RolandSobczak/stm32wba-dev/parts/Foshan_NationStar_Optoelectronics_NCD1206C1/LED1206_INF.step

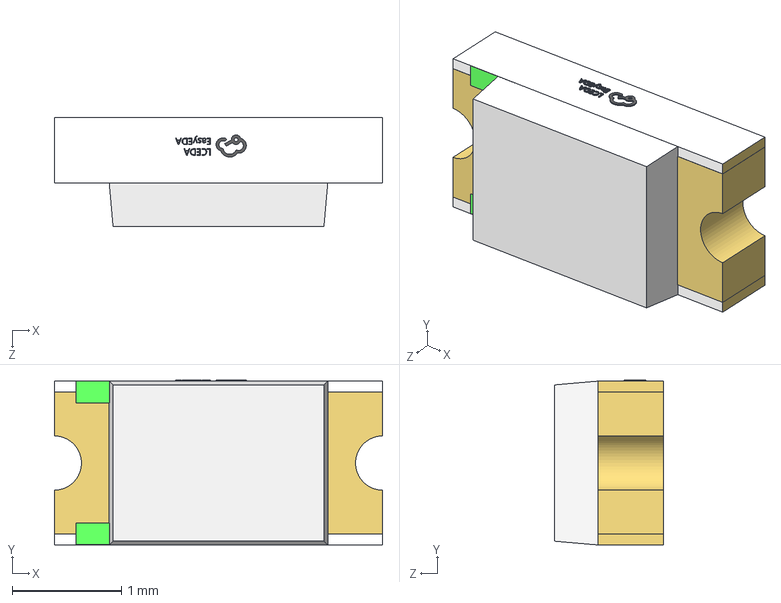
[picture p1: CAD file, 2026-10-15]
parts/Foshan_NationStar_Optoelectronics_NCD1206C1/LED1206_INF.step
3.00 x 1.51 x 1.00 mm
