RolandSobczak/stm32wba-dev/parts/Global_Connector_Technology_USB4085_GF_A/USC-C-SMD_USB4085-GF-A.step

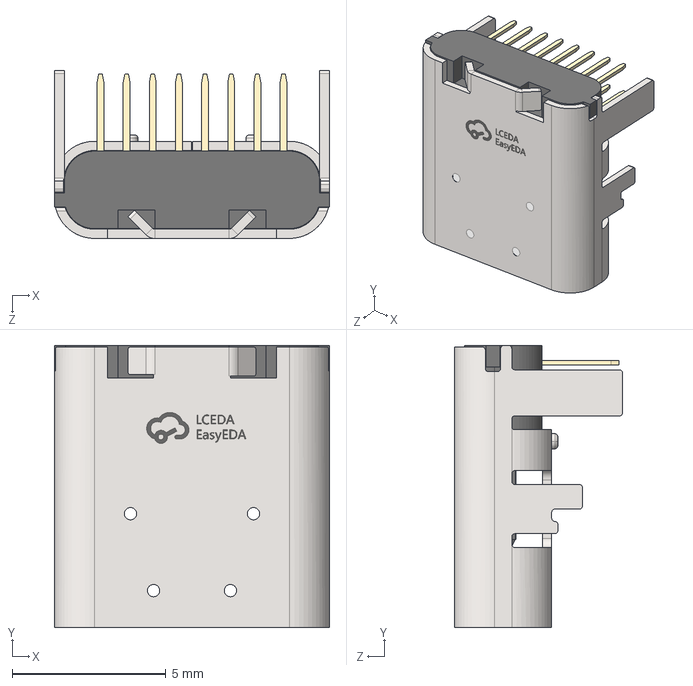
[picture p2: CAD file, 2026-10-14]
parts/Global_Connector_Technology_USB4085_GF_A/USC-C-SMD_USB4085-GF-A.step
8.94 x 9.17 x 5.46 mm
