RolandSobczak/stm32wba-dev/parts/MK_MKDV2GCL_ABF/LGA-8_L8.0-W6.0-P1.27_MKDV2GCL-ABF.step

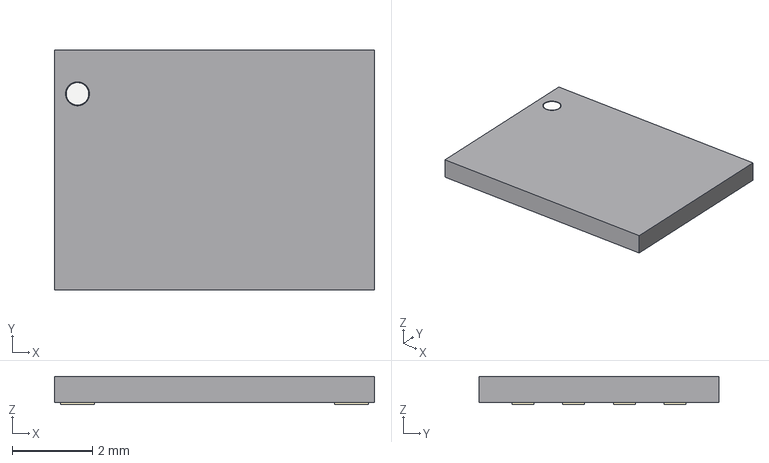
[picture p3: CAD file, 2026-10-15]
parts/MK_MKDV2GCL_ABF/LGA-8_L8.0-W6.0-P1.27_MKDV2GCL-ABF.step
8.00 x 6.00 x 0.7 mm
