RolandSobczak/stm32wba-dev/parts/Samtec_SHF_105_01_L_D_RA/SHF-105-01-L-D-RA.STEP

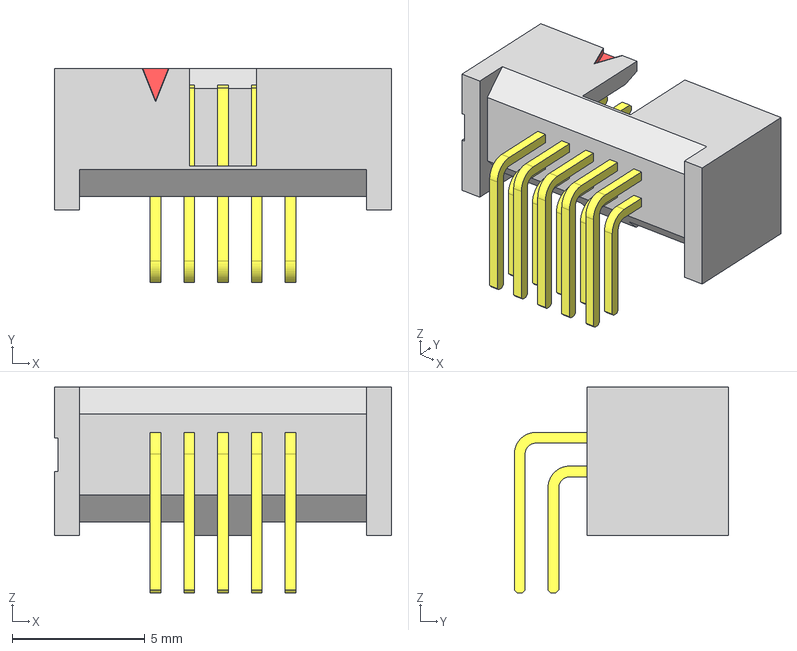
[picture p4: CAD file, 2026-10-14]
parts/Samtec_SHF_105_01_L_D_RA/SHF-105-01-L-D-RA.STEP
12.7 x 8.08 x 7.75 mm
SHF-105-01-D_header
SHF-First_Position_Indicator
T-1S71-02-05-D-RA
