RolandSobczak/stm32wba-dev/parts/STMicroelectronics_MLPF_WB55_01E3/FILTER-SMD_6P-L1.6-W1.0-P0.50-BL.step

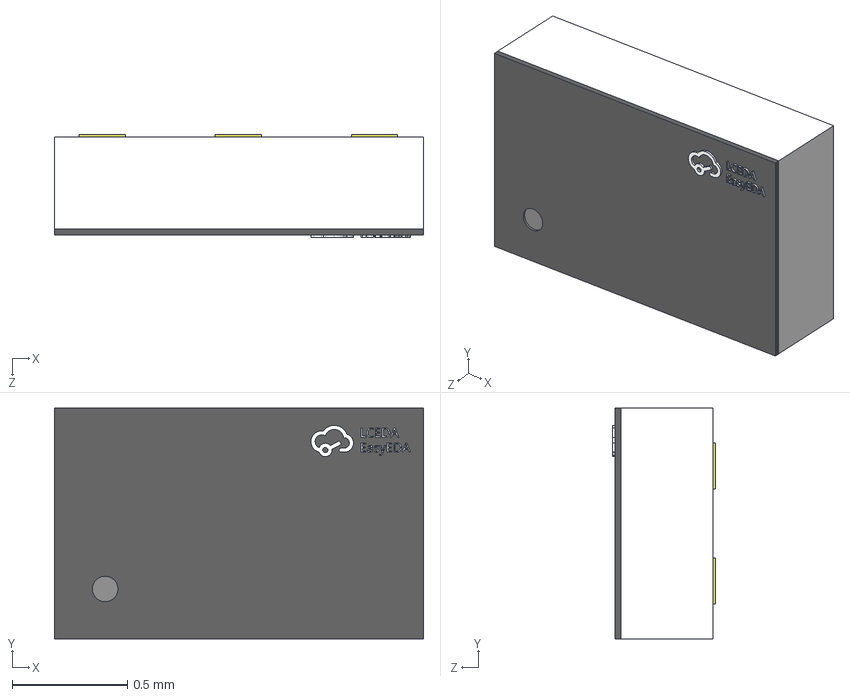
[picture p5: CAD file, 2026-10-14]
parts/STMicroelectronics_MLPF_WB55_01E3/FILTER-SMD_6P-L1.6-W1.0-P0.50-BL.step
1.60 x 1.00 x 0.445 mm
