RolandSobczak/stm32wba-dev/parts/STMicroelectronics_STM32WB55CGU6/VQFN-48_L7.0-W7.0-P0.50-BL-EP5.5.step

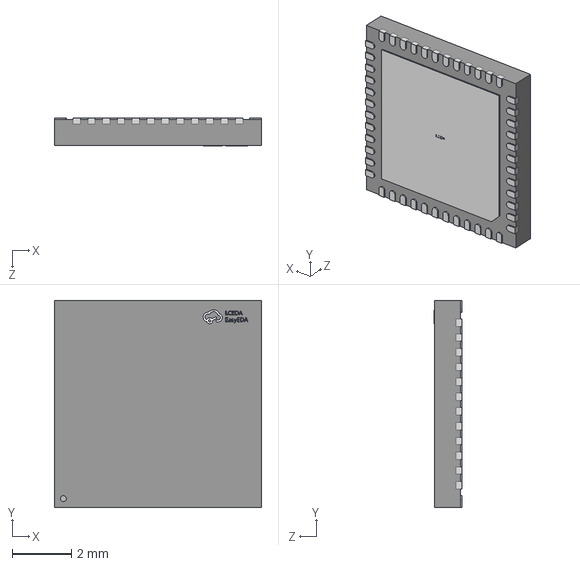
[picture p6: CAD file, 2026-10-14]
parts/STMicroelectronics_STM32WB55CGU6/VQFN-48_L7.0-W7.0-P0.50-BL-EP5.5.step
7.00 x 7.00 x 0.931 mm
