RolandSobczak/stm32wba-dev/parts/MK_MKDV2GCL_ABF/LGA-8_L8.0-W6.0-P1.27-TL_MKDV4GCL-ABF.STEP

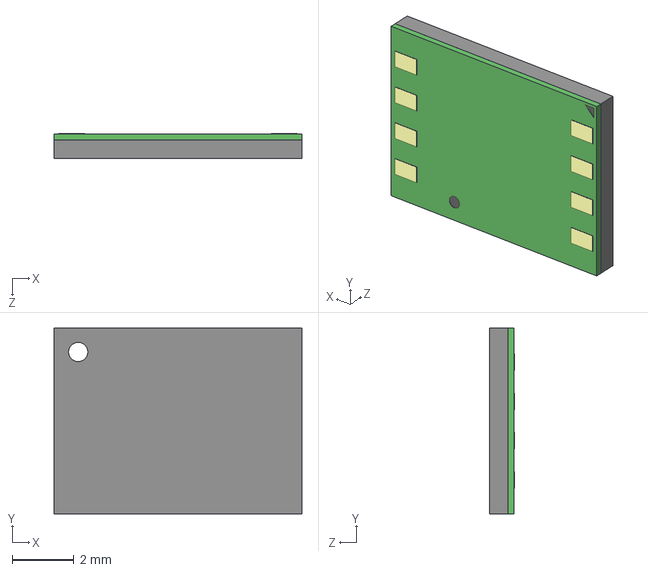
[picture p7: CAD file, 2026-10-14]
parts/MK_MKDV2GCL_ABF/LGA-8_L8.0-W6.0-P1.27-TL_MKDV4GCL-ABF.STEP
8.00 x 6.00 x 0.81 mm
