RolandSobczak/stm32wba-dev/layouts/dev/dev.kicad_pcb

## KiCad design layouts/dev/dev.kicad_pcb (2026-10-17)

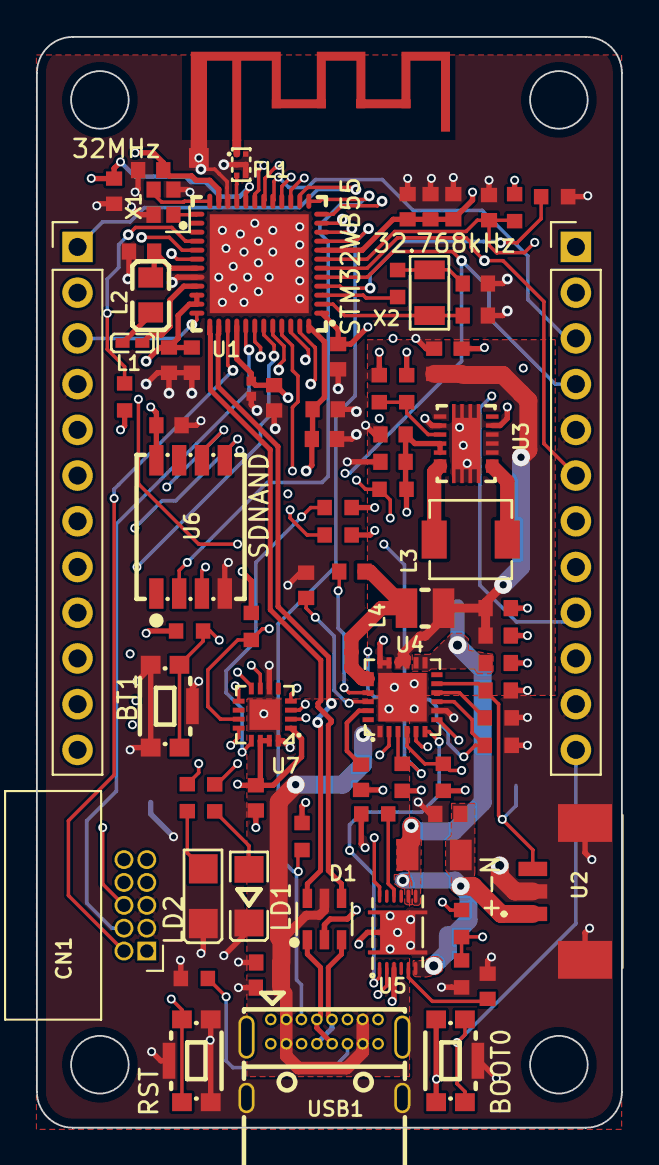
[picture p8: board dev.kicad_pcb from above]

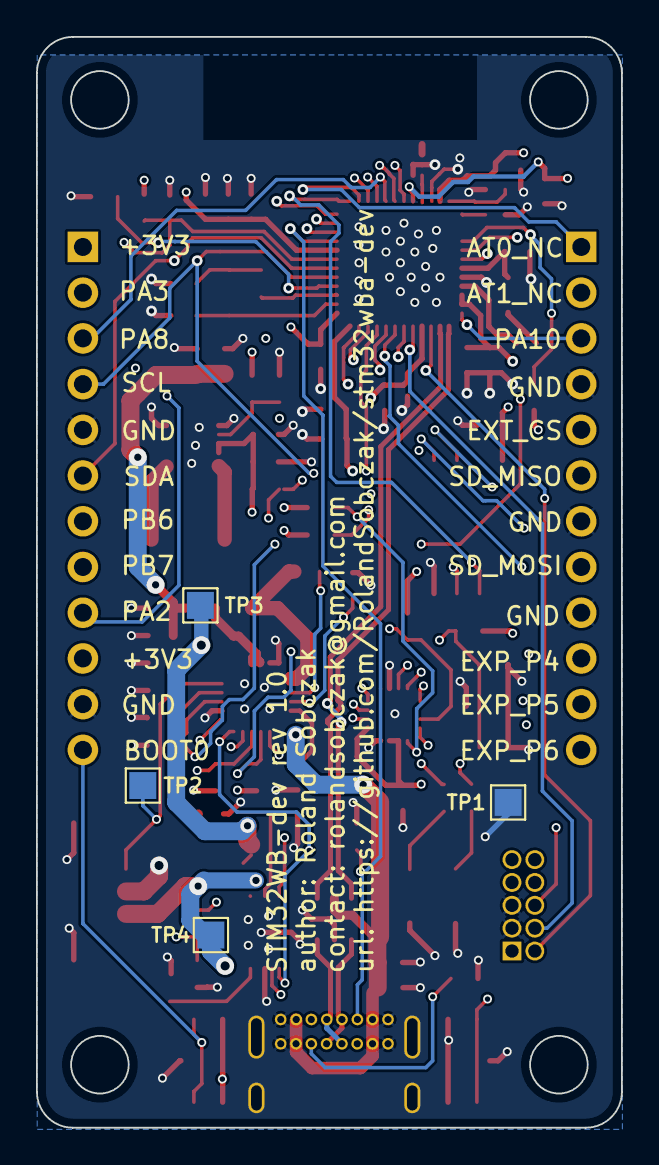
[picture p9: board dev.kicad_pcb from below]

Board: 6 copper layers, 32.5 x 60.6 mm, 85 parts (4 on the bottom side), 66 nets.

Parts:
AE1: Antenna_IFA_2G4
C1, C8, C9, C23: 4.7µF ±10%; C0603
C2, C3, C4, C7, C10, C12, C13, C15, C19, C26, C32, C33: 100nF ±10%; C0603
C5, C6: 12pF ±5%; C0603
C11, C27, C28, C29: 1µF ±10%; C0603
C14: 100pF ±5%; C0402
C16, C20, C22, C30, C31: 10µF ±20%; C0603
C17, C18, C24, C25: 22µF ±20%; C0603
C21: 47nF ±10%; C0603
CN1: CONN-THT_10P-P1.27_SHF-105-01-L-D-RA
D1: SOT-23-6_L2.9-W1.6-P0.95-LS2.8-BL
FL1: FILTER-SMD_6P-L1.6-W1.0-P0.50-BL
J1, J2: PinHeader_1x12
L1: L 10nH ±5%; L0402-RD
L2: L 10µH ±20%; L0805
L3: L 1.5µH ±20%; IND-SMD_L4.4-W4.2
L4: L 1µH ±20%; IND-SMD_L2.5-W2.0
LED1: LED1206-RD
LED3: LED1206-R-RD_RED
R1, R10, R14, R15, R16, R17, R20, R22: 10kΩ ±1%; R0603
R2: 0Ω; R0603
R3, R6: 100kΩ ±1%; R0603
R4: 180kΩ ±0.1%; R0603
R5: 1MΩ ±1%; R0603
R7: 121Ω ±0.1%; R0603
R8: 30kΩ ±0.5%; R0603
R9: 5.23kΩ ±1%; R0603
R11: 10mΩ ±1%; R1206
R12, R13: 4.7kΩ ±1%; R0603
R18, R19: 5.1kΩ ±1%; R0603
R23, R25: 1kΩ ±1%; R0603
SW1, SW2, SW3: KEY-SMD_KMR2XXGXXX
TP1, TP2, TP3, TP4: TestPoint_Pad_D1R5
U1: VQFN-48_L7.0-W7.0-P0.50-BL-EP5.5
U2: 532610371_Molex_PicoBlade_3Pin_1_25
U3: VSON-14_L4.0-W3.0-P0.50-BL-EP_TI_DSJ
U4: QFN-24_L4.0-W4.0-P0.50-TL-EP2.7
U5: SON-12_L4.0-W2.5-P0.40-TL-EP
U6: LGA-8_MKDV_handsolder
U7: QFN-16_L3.0-W3.0-P0.50-BL-EP1.7
USB1: USC-C-SMD_USB4085-GF-A
X1: CRYSTAL-SMD_4P-L2.0-W1.6-BL
X2: CRYSTAL-SMD_L3.2-W1.5-1

Connections:
+3V3: C1.1, C2.1, C3.1, C4.1, C8.1, C10.1, C11.1, C12.1, C13.1, C14.1, C15.1, C17.1, C18.1, C31.1, C32.1, C33.1, CN1.1, J1.1, J1.10, R3.1, R5.1, R12.1, R13.1, R14.1, R15.1, R16.1, R17.1, R20.1, R22.1, SW1.3, SW1.4, U1.1, U1.8, U1.20, U1.23, U1.34, U1.35, U1.40, U1.48, U3.4, U3.5, U6.8, U7.1, U7.14, U7.15
ANT: AE1.1, FL1.1
BIN: R10.1, U5.10
BOOT0: J1.12, R1.1, SW1.1, SW1.2, U1.4
BTN_USR: R20.2, SW3.1, SW3.2, U7.4
BTST: C21.1, U4.21
CC1: R18.1, U1.9, USB1.A5
CC2: R19.1, U1.10, USB1.B5
CHG_CE: R6.1, U1.29, U4.9
CHG_INT: R16.2, U1.28, U4.7
CHG_PG: R14.2, U1.30, U4.3
CHG_STAT: R15.2, U1.19, U4.4
EXP_INT: R22.2, U1.45, U7.11
EXP_LED0: R25.1, U7.2
EXP_LED1: R23.1, U7.3
EXP_P4: J2.10, U7.7
EXP_P5: J2.11, U7.8
EXP_P6: J2.12, U7.9
EXT_CS: J2.5, U1.42
FB: R4.1, R5.2, U3.3
GAUGE_INT: R17.2, U1.44, U5.12
GAUGE_VDD_1V8: C29.1, U5.5
GND: AE1.2, C1.2, C2.2, C3.2, C4.2, C5.2, C6.2, C7.2, C8.2, C9.2, C10.2, C11.2, C12.2, C13.2, C14.2, C15.2, C16.2, C17.2, C18.2, C19.2, C20.2, C22.2, C23.2, C24.2, C25.2, C26.2, C27.2, C28.2, C29.2, C30.2, C31.2, C32.2, C33.2, CN1.3, CN1.5, D1.2, FL1.2, FL1.4, FL1.5, FL1.6, J1.5, J1.11, J2.4, J2.7, J2.9, LED1.1, LED3.2, R1.2, R4.2, R6.2, R7.2, R8.2, R10.2, R18.2, R19.2, SW1.5, SW2.3, SW2.4, SW2.5, SW3.3, SW3.4, SW3.5, TP1.1, U1.22, U1.32, U1.49, U2.2, U2.4, U2.5, U3.2, U3.13, U3.15, U4.8, U4.17, U4.18, U4.25, U5.3, U5.13, U6.4, U7.6, U7.16, U7.17, USB1.A1, USB1.A12, USB1.B1, USB1.B12, USB1.S1, X1.2, X1.4
LED0_A: LED3.1, R25.2
LED1_A: LED1.2, R23.2
LIIM: R7.1, U4.10
LSE_IN: C5.1, U1.2, X2.1
LSE_OUT: R2.1, U1.3
LSE_XTAL: C6.1, R2.2, X2.2
NRST: C7.1, CN1.10, R3.2, SW2.1, SW2.2, U1.7
NTC: C26.1, R8.1, R9.2, TP2.1, U2.3, U4.11
OSC_IN: U1.25, X1.1
OSC_OUT: U1.24, X1.3
PA2: J1.9, U1.11
PA3: J1.2, U1.12
PA8: J1.3, U1.17
PA9: J2.2, U1.18
PA10: J2.3, U1.36
PB6: J1.7, U1.46
PB7: J1.8, U1.47
PMIC_SCL: J1.4, R12.2, U1.5, U4.5, U5.2, U7.12
PMIC_SDA: J1.6, R13.2, U1.6, U4.6, U5.1, U7.13
PMID: C22.1, U4.23
REGN: C23.1, R9.1, U4.2, U4.22
RF1: FL1.3, U1.21
SD_CLK: J2.1, U1.14, U6.3
SD_CS: U1.13, U6.2
SD_MISO: J2.6, U1.15, U6.6
SD_MOSI: J2.8, U1.16, U6.5
SMPS_MID: L1.2, L2.1
SWCLK: CN1.4, U1.41
SWDIO: CN1.2, U1.39
SWO: CN1.6, U1.43
SW_BAT: L3.1, U3.8, U3.9
SW_CHG: C21.2, L4.1, U4.19, U4.20
SW_OUT: L3.2, U3.6, U3.7
SYS: C16.1, C19.1, C24.1, C25.1, L4.2, U3.1, U3.10, U3.11, U3.12, U4.15, U4.16
USB_CONN_N: D1.3, USB1.A7, USB1.B7
USB_CONN_P: D1.1, USB1.A6, USB1.B6
USB_D_N: D1.4, U1.37
USB_D_P: D1.6, U1.38
VBAT: C28.1, R11.1, TP4.1, U2.1, U5.6, U5.8
VBAT_CHG: C20.1, R11.2, TP3.1, U4.13, U4.14, U5.7
VBUS: C27.1, C30.1, D1.5, U4.1, USB1.A4, USB1.A9, USB1.B4, USB1.B9
VFBSMPS: C9.1, L2.2, U1.31
VLXSMPS: L1.1, U1.33
