RolandSobczak/stm32wba-dev/(commit log)

2026-10-14 feat: STM32WB55 dev board - source, netlist, stackup and outline
    Power path lifted from gps_tracker-6l almost verbatim, comments included:
    GCT USB-C + USBLC6, BQ25896 NVDC charger, BQ27441 gauge with the shunt on
    the high side, TPS63020 buck-boost and the same Molex PicoBlade, so one
    cell fits both boards.
    Three things had to change and each is argued in the file:
    * CC without PD - STM32WB55 has no UCPD (checked against the peripheral
    list in STM32WB55CGUx.xml), so two 5.1k Rd plus an ADC on both CC
    nodes. The source advertises its current through Rp regardless of PD;
    firmware reads it, writes IINLIM and kicks FORCE_ICO. Side effect is
    welcome: Rd works with a dead MCU, so a freshl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
2026-10-14 feat: SWD on a proper ARM Cortex Debug connector
    Samtec SHF-105-01-L-D-RA, right-angle, keyed shroud, 2x5 at 1.27 mm. The
    J-Link EDU Mini cable plugs straight in, and so does ST-LINK V2/V3 - it is
    a standard rather than somebody's pin order. Right-angle because a vertical
    one with the cable attached stands about 7 mm above the laminate, exactly
    where a probe and fingers need to be during bring-up.
    Two grounds sit between the fast lines (pin 3 between SWDIO and SWCLK,
    pin 5 between SWCLK and SWO), so each has a return in the neighbouring
    ribbon wire. That matters most for SWO, which carries the ITM console.
    The four positions on the left header that used to carry SWD (5 NRST,
    6 SWDIO, 8 SWC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
2026-10-14 docs: list the SWD connector among the parts bought outside LCSC
    Claude-Session: https://claude.ai/code/session_01BM8NndJbzBEDPtrpVjN835
2026-10-14 chore: board file after the SWD rebuild
    ato build plus board_setup.py, no source change. Picks up CN1 in the PCB
    and the net classes rewritten in the project file.
    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
2026-10-14 feat: stitch the thermal pads of the leadless packages to ground
    For the STM32WB55 in UFQFPN-48 this is not a nicety: that package has no
    VSS pin at all, so the pad under the body is the chip's ONLY connection to
    ground, and the In1 plane sits 0.2104 mm below the top layer with no other
    way down. U1 gets 5x5 = 25 vias in its 5.50 mm pad at a 1.12 mm pitch,
    U4 gets 2x2 in its 2.70 mm pad. Vias are 0.50/0.25, 0.25 mm of pad left
    around each.
    Packages are matched by footprint name (QFN/SON/DFN), the way sieci_bga
    already matches BGA - designators renumber on every rebuild, package names
    do not. A pad-area threshold separates thermal pads from signal ones.
    The grid follows placement: it is rec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
2026-10-14 fix: keep every drill at 0.3 mm, shrink signal vias to 0.5 mm
    A JLCPCB quote (100 x 100, 5 pcs, 4 layers) settles two open questions.
    Via-in-pad costs EUR 18.91 there: Via Covering 15.85 plus a forced
    Horizontal Electroless Copper Plating 3.06, taking the board from 7.13 to
    26.03. Six layers include the same process and land at 28.52 - only 2.49
    more - but at an 8-9 day build instead of 3-4, and without HASL.
    The other finding drives this commit: in "Min via hole size/diameter" only
    the first tier, 0.3mm/(0.4/0.45mm), is free. Every smaller one raises the
    price of the whole order, and a single forgotten 0.25 mm via is enough.
    So:
    * PAD_VIA drill 0.25 -> 0.30. Diameter stays 0.50, which is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
2026-10-14 feat: six-layer stackup so the in-pad vias get filled for free
    The ground pad of the WB55 is the only ground the chip has, and it now
    carries a 5x5 grid of vias. Unfilled vias in a pad drink more solder than
    the pad holds: one 0.3 mm barrel through 1.6 mm of laminate is 0.113 mm^3,
    while a 0.12 mm stencil at 60 % coverage leaves about 1.09 mm^3 on the
    5.5 x 5.5 pad - so nine open vias already match the whole joint and
    twenty-five are two and a half times it.
    JLCPCB charges EUR 18.91 to fill vias on four layers (Via Covering 15.85
    plus the forced Horizontal Electroless Copper Plating 3.06), taking the
    order from EUR 7.13 to 26.03. Six layers include the process and cost
    EUR 28.52 - EUR 2.49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
2026-10-15 chore: board file after routing and the In4 refill
    Routing grew from 280 to 636 segments and 89 to 158 vias. All six zones
    are filled again, with +3V3 on its new home In4.
    The project file also carries a hand change: zone min_clearance 0.2 -> 0.1
    mm. tools/board_setup.py writes that field from ZONE_CLEARANCE_MM = 0.2,
    so the next run of the script puts 0.2 back. The constant has not been
    touched here - it needs a decision, not a guess.
    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
2026-10-15 feat: build the SD NAND 3D model from the datasheet table
    The LGA-8 footprint carried no model at all, so the memory was a hole in
    the 3D view. The EasyEDA file sitting next to it cannot be used:
    * it reaches 0.21 mm BELOW the seating plane - the package would sink
    into the laminate instead of standing on it,
    * it is 0.81 mm tall where the datasheet gives A = 0.65 / 0.70 / 0.75,
    * a stray point at (0, -3.81, -0.21) stretches its bounding box to
    6.81 mm on a 6.00 mm package.
    Its pad geometry is right, though, and that is the check on this one:
    edges computed independently from the dimension table (X 3.000 / 3.850,
    Y 0.360 / 0.910 / 1.630 / 2.180) land on the vendor model to th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
2026-10-15 chore: hang the SD NAND model on U6 in the board file
    The footprint instance on the board keeps its own copy of the library
    footprint, so the model added to the library did not reach it. Eleven
    lines inserted into the U6 block and nothing else - the diff against the
    pre-edit copy is exactly those eleven lines.
    Verified through KiCad 9 pcbnew: the board loads, U6 reports the model,
    74 footprints and 793 tracks unchanged. The only footprints still without
    a model are AE1 and TP1-TP4, which are bare copper and have nothing to
    show.
    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
2026-10-15 feat: put USART1, LPUART1, I2C1 and SPI1 on the headers
    The chip sets the ceiling, not the header. STM32WB55CGUx.xml ends at I2C1,
    I2C3, USART1, LPUART1, SPI1 and QUADSPI - there is no SPI2, no I2C2, no
    USART2. The larger packages have SPI2, but its pins (PB12-PB15, PC2/PC3,
    PD0-PD4) are not bonded out in UFQFPN-48.
    QUADSPI is dead here too: QUADSPI_CLK exists only on PA3, and PA3 is the
    only possible LPUART1_RX (the other, PA12, is USB D+); BK1_IO0 is PB9 and
    BK1_IO1 is PB8, the PMIC bus. Turning it on would cost the second UART and
    charger control at once.
    Header real estate was 13 positions, not 9 - the left strip still had four
    empty ones left over from SWD. Fourteen signals wanted the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
2026-10-15 feat: add RESET and BOOT0 buttons and a TCA9534 I/O expander
    The two system buttons cost nothing and fix the two most common physical
    operations on the board. NRST and BOOT0 are not GPIO, so no pin is spent,
    and both switches hang on nets that already have names - they introduce no
    new net at all. Resetting used to mean shorting header pins or cutting
    power; DFU meant a wire from J2-11 to J2-3. Now it is hold BOOT0, tap
    RESET.
    No series resistor on RESET, deliberately: the switch discharges the 100 nF
    through its contacts, which erodes them slowly, but AN2586 and every Nucleo
    and Discovery wire that button directly, and departing from a convention on
    a board meant to feel familiar costs mor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
2026-10-15 refactor: swap the TSSOP-16 expander for a 3x3 QFN
    The TCA9534 in TSSOP-16 measured 5.86 x 7.47 mm on the board - 43.7 mm2 of
    courtyard on a board whose largest free block is 13 x 8.5 mm. TCA6408A in
    VQFN-16 does the same job in 3.56 x 3.83 mm, or 13.6 mm2. Less than a
    third, and nothing is given up: still 8 I/O, still an interrupt, still
    push-pull outputs, still 1.65-5.5 V.
    The 4-bit alternative in VSSOP-8 (PCA9536) would have saved slightly more
    once its spare pull-downs are counted, but at the cost of half the I/O and
    the interrupt entirely. The QFN keeps the whole design and costs only the
    package style, which is the same 0.5 mm pitch as the MCU already on this
    board.
    Three things the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
2026-10-15 fix: refuse to rewrite the board while pcbnew has it open
    The QFN swap was lost minutes after it was committed. Killing the kicad
    process only takes down the project manager; pcbnew runs separately, kept
    its own copy of the board in memory from before the rebuild, and wrote that
    copy back over the file. The board on disk went back to the TSSOP-16
    footprint while the commit held the correct one.
    board_setup.py now looks for KiCad's lock files next to the board and
    stops before touching anything if it finds one. The cost of a false
    positive is one message; the cost of a false negative is silently undoing
    whatever the script just produced.
    layouts/dev/dev.kicad_pcb is restored from 755ebdd. N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
2026-10-15 feat: cut the expander load to two LEDs and one button
    Three LEDs and two buttons measured 166.5 mm2 of courtyard and did not fit
    the board's free pockets. Two LEDs and one button do. The expander stays -
    on a dev board the eight ports are worth having, the part is cheap, and
    these boards are hand-assembled so JLCPCB's extended-part feeder fee never
    applies.
    Seven parts leave the board: one LED with its resistor, one button with its
    pull-up, and the three spare pull-downs. 92 footprints down to 85.
    The five unused ports now carry no resistors at all, which the datasheet
    sanctions explicitly: "Resistors are required for inputs (on P-port) that
    may float ... Outputs (in the P-port) do not ne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
2026-10-15 feat: back-annotate header pin order from the board into headers.ato
    Signal order on a header only reveals itself during routing - that is when
    two lines cross and the fix is to swap them. pcbnew is the natural place to
    make that change, and it should be allowed.
    The hazard is that atopile treats .ato as the only source of truth. The next
    ato build rewrites pad-to-net assignment from the code while the copper
    stays where it was drawn, so the traces quietly start connecting something
    else. No error is raised. Any such edit has to travel back into the source
    before the next build, and a promise to remember is not a mechanism.
    The tool computes a permutation rather than keeping a net-to-field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
2026-10-16 feat: bring the hand-reworked headers and mounting holes into the source
    Layout work in pcbnew moved the signals around on both headers, brought
    three spare expander ports out, relocated the M3 holes and deleted the
    inherited 2.0 mm set. The source now describes exactly that, so the next
    ato build reproduces it instead of reverting it.
    Headers:
    J2 (left) 1 SD_CLK 2 PA9 3 PA10 4 GND 5 EXT_CS 6 SD_MISO
    7 GND 8 SD_MOSI 9 GND 10 EXP_P4 11 EXP_P5 12 EXP_P6
    J1 (right) 1 +3V3 2 PA3 3 PA8 4 PMIC_SCL 5 GND 6 PMIC_SDA
    7 PB6 8 PB7 9 PA2 10 +3V3 11 GND 12 BOOT0
    The left strip has no supply rail any more, only ground; +3V3 moved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
2026-10-16 fix: stitch thermal pads by their real copper, not their bounding box
    The TPS63020 and BQ27441 exposed pads were never stitched, and for the
    whole project the tool reported them as "0.01 x 0.01 placeholders, not
    thermal pads". That reading was wrong. Both are custom pads: 0.01 x 0.01 is
    the anchor size and the real shape lives in the primitives. Measured on the
    board they are 1.58 x 4.40 mm (6.95 mm2) and 3.30 x 2.45 mm (8.09 mm2),
    both on F.Cu with paste and both on GND. The footprints were fine all
    along; the tool could not see them because it read GetSizeX/GetSizeY.
    Reading the bounding box instead fixes the detection and breaks two other
    things, both of which surfaced immediately:
    * th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
2026-10-16 feat: grow the board 1 mm upward and make the pours connect to pads
    Two findings drove this, and the second one explains four unconnected
    ground items at once.
    The pours were set to ZONE_CONNECTION_NONE - all six of them, including the
    In1 ground plane and the In4 power plane. A pour in that mode keeps
    clearance from pads of its own net, so every ground pad without an explicit
    track or via to it was left floating: the antenna's shorting stub, which is
    the entire operating principle of an inverted-F; the MLPF's ground; and the
    shields of both buttons. nowa_wylewka() has always set FULL, but set_zones
    never corrected the pours it found, and that is the gap.
    They are now forced to THT_THERMAL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
2026-10-16 fix: give the antenna's shorting stub somewhere to land
    The inverted-F had no DC path from its radiator to ground, which is not a
    detail - the short to ground is the entire operating principle. Without it
    the structure is a piece of copper at an undefined impedance.
    The cause was dimensional. The comment at ANTENA_KEEPOUT_MM has always said
    the two towers drop below the keepout into ground, "tam laduje przelotka
    zwierajaca", so a shorting via was part of the design from the start. It was
    never placed because it never could be: the stub foot from AN043 Table 1 is
    0.90 x 0.50 mm and a 0.5 mm via with clearance needs 0.80 mm in both axes.
    The footprint gains one rectangle that is not in Table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
2026-10-17 fix: put the hand-tuned clearances into the script and force them on zones
    Two settings changed in KiCad during layout would have been overwritten by
    the next board_setup run, the same way an earlier min_clearance edit already
    was. They are now in the script.
    RF netclass clearance 0.30 -> 0.15. The 0.30 was a wish, not a dimension:
    at the MCU the RF trace threads between pins 19-24 on a 0.5 mm pitch and
    there is nowhere to move it. 0.15 is what the rest of the board uses and
    still sits above JLCPCB's 0.127 minimum.
    Zone clearance 0.20 -> 0.15, not the 0.10 that was asked for. Two reasons,
    and the second one makes the first moot: 0.10 is below the 0.127 the README
    records as JLCPCB's floor,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
2026-10-17 feat: place the antenna's shorting via from the script
    The shorting via is what makes an inverted-F an antenna - the radiator is
    tied to ground through the stub, and without that tie the structure is just
    copper at an undefined impedance. The comment at ANTENA_KEEPOUT_MM has
    assumed this via since the beginning, but it was never placed: the stub foot
    from AN043 is 0.90 x 0.50 mm and a via with clearance needs 0.80 in both
    axes. The landing pad added to the footprint finally gave it room.
    It belongs in the script rather than in the board by hand, because
    board_setup runs after every build and a via this important should be
    reproducible, not remembered.
    The pad is chosen geometrically, not b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
2026-10-17 feat: port the fabrication export from the tracker
    The board had nothing to send: no gerbers, no drill files, no placement
    file. This was the one unconditional blocker on the readiness list,
    independent of the state of the copper.
    The script comes from gps_tracker-6l almost unchanged, because it reads
    everything it needs from the board file itself - LCSC, Manufacturer and
    Partnumber live in footprint fields, so atopile is not involved. Source is
    the board in git rather than a rebuild: what is committed is what goes to
    the fab, hand-routed copper and all.
    It produces 16 gerbers, a JLCPCB BOM of 39 line items covering 77 placed
    parts, a position file for the same 77, a PDF, a STEP model, and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
2026-10-17 feat: bring the silkscreen down to what JLCPCB can actually print
    Component designators came from four different sources and carried four
    different sizes, from 0.50 x 0.062 mm up to 1.27 x 0.254. JLCPCB's absolute
    minimum is 0.8 mm character height and 0.15 mm stroke; 25 designators were
    at 0.50 x 0.062 and four more at 0.60 x 0.075. Below 0.15 the fab widens
    the stroke itself, which on a 0.5 mm character turns a 1:6 width-to-height
    ratio into 1:3 - a smudge where a letter should be.
    All 86 designators are now 0.80 x 0.15, unbolded. That is the minimum
    rather than the recommended 1.0 x 0.2 on purpose: the board is crowded and
    a fifth off every label is a fifth less crowding, and these are r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
2026-10-17 feat: remove copper that leads nowhere
    Routing leaves offcuts: a track fragment after a connection was redrawn, a
    via left behind when a signal moved, a twelve-micrometre segment from a
    misclick. None of it connects anything.
    It does not block fabrication - the fab etches what it is given - but a
    dangling via on a controlled-impedance trace is a stub, and two of them
    were sitting on USB_D_N, one half of the differential pair. The rest just
    fill the DRC report and hide warnings that mean something.
    Six pieces removed: three vias (EXP_P3_NC, two on USB_D_N) and three
    tracks (NRST 0.190 mm, EXP_INT 0.012 mm, and an EXP_P3_NC segment of
    0.928 mm). That last one is why the loop is iterative - i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
2026-10-17 chore: board after a rebuild run to test the library mismatch
    DRC reports lib_footprint_mismatch on AE1 and CN1, and the question was
    whether the next ato build would change them under the finished routing.
    It does not. Position, orientation and every pad - coordinates and nets -
    come through a rebuild unchanged, and so does the copper: 1030 segments,
    226 vias, and comparing both as sets rather than by file order gives a
    symmetric difference of zero on each.
    The mismatch itself is formatting. These two are the only hand-written
    footprint libraries in the project - the antenna generated from AN043 and
    the Samtec connector marked generator "reczny" - and they spell numbers as
    -2.5400 where Ki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
2026-10-17 chore: silkscreen pass and final fabrication package
    Hand work in pcbnew moved silkscreen labels and angles; no copper was
    touched, which the diff confirms - zero lines involving segments, vias,
    pads or zone fills.
    Silk over exposed copper drops from 52 to 38. Those are the ones that
    matter, because the fab strips silkscreen off bare copper and the label
    arrives clipped. Edge clearance 8 to 7. Overlaps stay at 199. Warnings
    overall 327 to 313.
    board_setup left the new positions alone, as intended - it normalises size,
    stroke and bold, never placement. Of 120 texts it corrected 6, all sizes.
    clean_copper reports nothing dangling.
    Fabrication package regenerated and checked: six copper laye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
2026-10-17 feat: split the assembly set from the purchase list
    Two different questions were being answered by one file. What JLCPCB
    should solder and what needs buying are not the same list, and conflating
    them means either paying feeder fees for resistors or forgetting to order
    the parts you solder yourself.
    bom_montaz_jlc.csv and cpl_montaz_jlc.csv carry nine parts: the six
    leadless packages - QFN, SON, DFN and LGA, which have no legs at all and
    cannot be reached with an iron, with a thermal pad and 22 stitching vias
    under the MCU - plus FL1 and both crystals. FL1 has six pads on 0.50 mm
    pitch on a 1.6 x 1.0 mm body and sits in the RF path, where a cold joint
    shows up as missing range rather than as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
2026-10-17 fix: local power pours no longer swallow the top layer
    The F.Cu pours for SYS and VBUS had board-wide outlines and the higher
    priority, so VBUS filled 906 mm2 - 46 % of the top layer - and pushed
    ground down to 157 mm2 in 55 fragments. In the strip around the antenna
    that meant 102 mm2 of VBUS against 7 mm2 of ground: the inverted-F
    radiator is DC-shorted to the ground plane and that plane is its
    counterpoise, so the metal beside it has to be ground, not a 5 V rail
    that floats whenever USB is unplugged. The 66 isolated_copper warnings
    were the unconnected VBUS fragments.
    Root cause was in set_zones: it treated every single-layer pour on an
    outer layer the same, and its "a pour smaller than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
2026-10-17 feat: passives off the silkscreen, Power class widened to 1.0 mm
    Two changes, both in board_setup.py so they survive `ato build`.
    Passives off the silkscreen. The 56 R/C footprints carried 468 of the
    board's 683 silkscreen graphic items, and they - not the text - were the
    source of the clutter: of 243 silkscreen warnings, 158 were outline-on-
    outline pairs, because 0402 and 0603 bodies sit closer together than
    their outlines are wide. This board is hand-soldered with KiCad open, so
    the printed outline buys nothing.
    Moved to *.Fab rather than deleted. The geometry stays visible in pcbnew,
    so nothing is lost while soldering - it only leaves the silkscreen
    gerber, which is where it was in the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
2026-10-17 chore: C29 clear of the M3 screw, new silkscreen labels brought to spec
    Hand changes preserved from this layout session:
    * U2's courtyard trimmed. The oversized one pushed C29 out to where it
    sat under the M3 screw head at the top-right hole. C29 moved from
    (34.544, 57.404, -90) to (33.452, 55.042, 90) and is now 4.22 mm from
    the hole centre - clear of both the 5.5 mm screw head and a 7 mm
    washer. Measured, not assumed.
    * Three silkscreen labels added by hand: "32MHz", "32.768kHz" and a
    knockout "BT1". Far more useful on a board whose passive designators
    now live on *.Fab.
    * The TrueType back-side text block is gone. That retires the one
    text_thickness warning whose glyph stem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
2026-10-28 fix: CN1 was missing from every shopping list
    The SWD connector carried the placeholder "SHF-105-01-L-D-RA" in
    supplier_partno, which the exporter reads as "no catalogue number" and
    files under hand assembly. That is the right call for JLCPCB, but it
    also meant the part appeared in no list you could take to a shop - you
    had to remember it. Checked: LCSC does stock it as C17186479 at about
    2.60 USD, so the placeholder was simply wrong.
    Noted in the docstring: stock runs in single units, so C17609174
    (SHF-105-01-L-D-RA-TR, same part on tape) is the fallback.
    J1/J2 and TP1-TP4 deliberately keep no number. Pin headers are bought as
    a 1x40 strip and cut, and forcing a number would make atopile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
2026-11-04 fix: 100nF decoupling -> C1591, replacing C14663
    C14663 (YAGEO CC0603KRX7R9BB104) could not be bought, so all ten uses of
    the 100nF 0603 decoupling cap move to C1591 (Samsung CL10B104KB8NNNC):
    same 100nF, 0603, X7R, 50V, +/-10%. atopile's stock query reports
    7,839,924 pieces, so this one will not run dry.
    Ten sites across four files - six in mcu.ato (VDD rail decoupling, VDDA,
    VDDUSB, VBAT, VDDRF, NRST), two in power.ato (charger TS divider, buck
    VINA), one in storage.ato, one in ui.ato. All already carried the same
    constraints, which the replacement satisfies:
    capacitance = 100nF +/- 10%
    package = "0603"
    assert max_voltage within 10V to 50V
    Worth noting that assert has an UPP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
