RolandSobczak/stm32wba-dev/(notices)

Notices in the files:
parts/Samtec_SHF_105_01_L_D_RA/SHF-105-01-L-D-RA.STEP:
author */ ('License CC BY-ND 4.0'),
